einsiedlerkrebs/TramSeq/README.md

# TramSeq
Arduino midi controller over ethernet
